philippedc/Arduino-Uno-Water-Heater-Thermostat-for-PWM-pumps/Thermostat_final.jpg

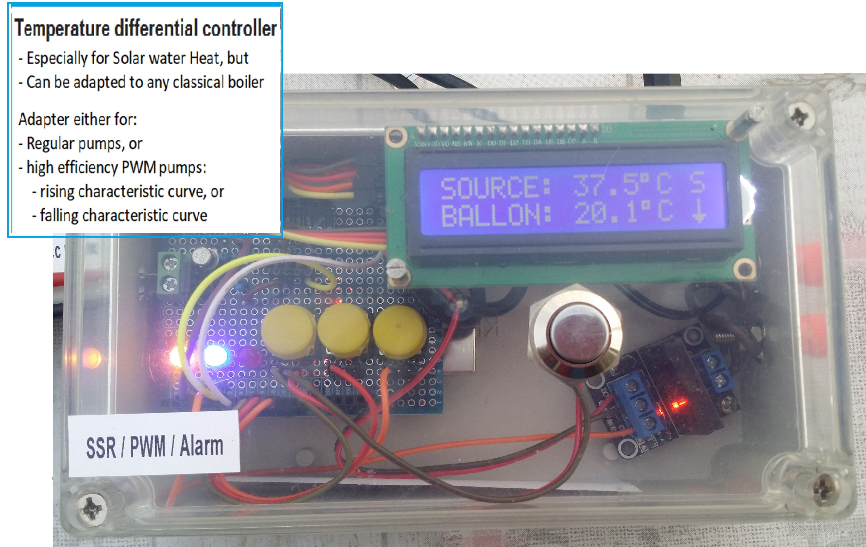
Thermostat_final.jpg
