philippedc/Arduino-Uno-Water-Heater-Thermostat-for-PWM-pumps/Thermostat_PCB.JPG

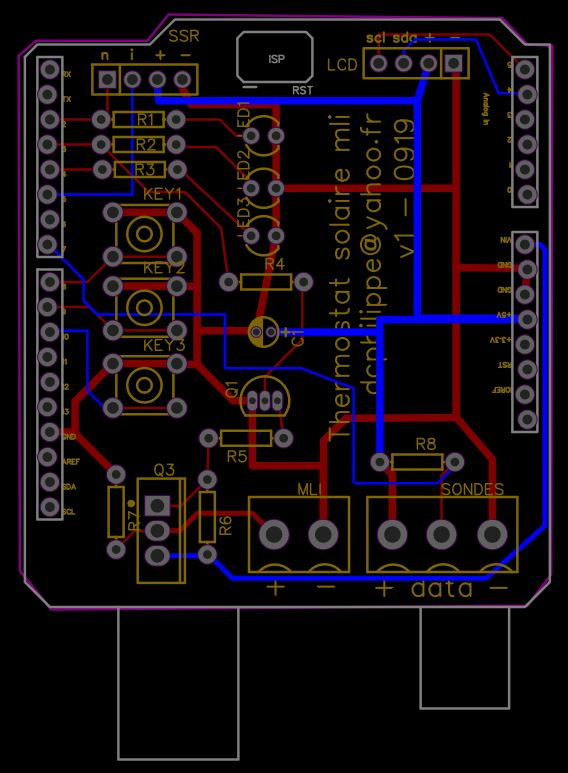
Thermostat_PCB.JPG
