philippedc/Arduino-Uno-Water-Heater-Thermostat-for-PWM-pumps/(threads)

Thread 1 (2020-11-03):

Request for additional features

robas781, 2020-11-03:
Hello. Sorry for my English (google translator). I would like to thank you for sharing this project and if it was possible to add a small change that is necessary in my application of this controller. I built a heat pump from an air conditioner and wanted to use your controller to control the operation of the circulation pump to maintain the set water delta Unfortunately, the air heat pump defrosts from time to time and then first stops heating, which means that the circulation pump will reduce its speed and then turn off, and then when defrosting starts, the water will be cooled, not heating, so the circulation pump will not work resumed (no required delta) and the exchanger will freeze.To solve this, I would need the controller to measure the temperature at the 3rd point and, having detected the temperature in the range (0-20 degrees with the possibility of setting in the program), turned on the circulation pump for 100 percent (or any other percentage set in the program) Circulation pump off and waiting that the delte required to start normal operation would take place after reaching the temperature in the range of 10-30 degrees (set in the program). Thanks to this additional function, water flow during defrosting should be ensured.
